takakurausp/diy_nanodrop/nanodrop_circuit.png

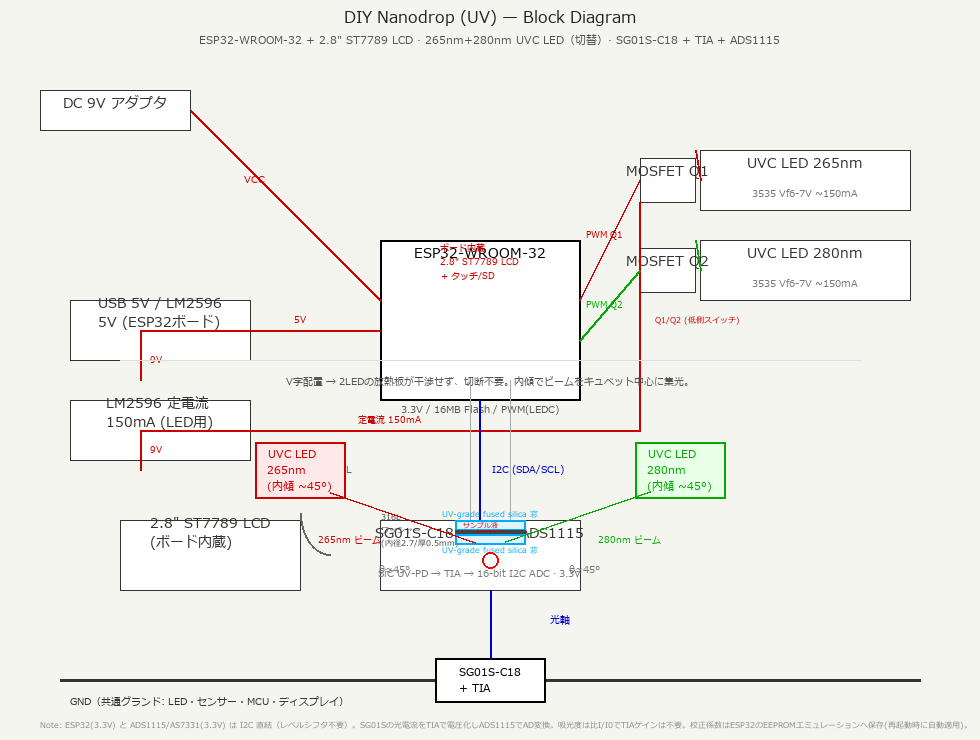
nanodrop_circuit.png
