takakurausp/diy_nanodrop/nanodrop_BOM.md

# DIY Nanodrop (UV) — 部品リスト（BOM）/ Cost-optimized, 260+280nm dual measurement
> SG01S-C18（SiC UVフォトダイオード）+ TIA + ADS1115 + ESP32 構成。AS7331 もビルドオプション選択可。旧 GUVA-S12SD 版は `main`、LGT8F328P+AS7331 版は `as7331` ブランチを参照。
>
> 前提ボード: **ideaspark ESP32 2.8" IPS LCD タッチボード (240x320, ST7789)** — https://www.amazon.co.jp/dp/B0HHSHFZ8Q

## コア部品
| # | 部品 | 仕様 / 品番 | 用途 | 参考価格 | 購入先 |
|---|---|---|---|---|---|
| 1 | 開発ボード | **ESP32-WROOM-32 + 2.8" IPS LCD (ST7789 240x320) + XPT2046タッチ + microSD 一体ボード** (16MB Flash, 3.3V, USB Type-C) | メインMCU兼ディスプレイ。空きGPIO 5/12/16/17/21/22/25/26/33 | ¥1,299 | [Amazon](https://www.amazon.co.jp/dp/B0HHSHFZ8Q) |
| 2 | UVC LED | 265nm SMD 3535 単一素子 (Vf 6-7V, ~150mA) | DNA A260光源 | ¥100〜300/個 | [AliExpress](https://www.aliexpress.com/item/1005009337588215.html) |
| 3 | UVC LED | 280nm SMD 3535 単一素子 (Vf 6-7V, ~150mA) | タンパク質 A280光源 / 純度比用 | ¥100〜300/個 | [AliExpress](https://www.aliexpress.com/item/1005009337588215.html) |
| 4 | UVセンサー(既定) | **SG01S-C18** (sglux SiC UVフォトダイオード, TO-18, 単一ch) + **トランスインピーダンスアンプ(TIA)** + **ADS1115** (16-bit I2C ADC) | 自作センサーモジュール。光電流 → TIA → ADS1115 でAD変換。吸光度は比 I/I0 なので TIA ゲインは式上キャンセル | SG01S ¥3,000〜5,000 / ADS1115 ¥300〜600 | sglux 等 / AliExpress |
| 4b | UVセンサー(代替) | **AS7331** モジュール (SparkFun SEN-23517 Qwiic 1x1 / 23518 Mini, 2.7-3.6V) | 3ch(UVA/UVB/UVC)デジタルI2C検出器。ビルド時 `SENSOR_AS7331=1` で選択 | ¥2,500〜3,500 | SparkFun/スイッチサイエンス 等 |
| 4c | UVセンサー(旧/互換) | **GUVA-S12SD** モジュール (アナログ出力 0-1V) | 同じアナログ経路が使えるが単一広帯域chで感度・選択性は SG01S より劣る | ¥200〜500 | AliExpress/Amazon |
| 5 | MOSFET | **MTA100N10KRI3** (N-ch, TO-251, Vds100V, Id10A, RDS(on)@4.5V=112mΩ, 論理レベル) | LED駆動用スイッチ ×2（低側） | ¥100×2 | Amazon/通販 |

## 抵抗・保護
| # | 部品 | 値 | 用途 |
|---|---|----|---|
| 6 | ゲート抵抗 | 100Ω | MOSFETゲート直列(振動抑制) ×2 |
| 7 | フライバックダイオード | 1N4148 または SS34 | LED逆起電流保護 ×2 (任意だが推奨) |
| 8 | デカップリングコンデンサ | 100µF + 0.1µF | 電源ノイズ除去(MCU/センサー共通) |
| 8a | TIA用オペアンプ | 低入力バイアス電流・低オフセット（例: LMP7721, OPA381, OPA333） | SG01S の光電流を電圧へ I-V 変換 |
| 8b | TIA帰還抵抗 Rf | 1MΩ〜10MΩ（薄膜・低ドリフト） | 変換ゲイン G=Iph×Rf。出力が ADS1115 の ±4.096V 内に収まる値にする |
| 8c | TIA帰還コンデンサ Cf | 1〜10pF（C0G/NP0） | 発振防止・帯域制限 |

## 電源(9V供給・LED用定電流 + 5V生成)
| # | 部品 | 仕様 / 品番 | 用途 |
|---|---|---|---|
| 14 | 定電流ドライバ(LD用) | LM2596 CC/CV降壓モジュール(二つトリム:電流+電圧) | LED用定電流。電流トリムを150mAに固定し、順電圧に合わせて自動調整 |
| 15 | 降圧DC-DC(MCU用) | LM2596 降壓モジュール(5V固定) | ESP32ボードへ 5V 給電（ボード上のレギュレータで3.3V生成）。3端子レギュタより発熱が小さい |
| 16 | 9V電源 | DC9Vアダプタ(500mA〜1A級) | 装置全体への供給。USB給電でも可 |

### 電源構成（9V供給）
- **LM2596×2**: 1つはLED用定電流(150mA固定)、もう1つはESP32ボード用5V定電圧（USB Type-C給電なら不要）。
- ESP32ボードは 5V 入力（USB/5Vピン）を受け、オンボードで 3.3V を生成。AS7331 も同じ 3.3V から給電。
- LED素子は順電圧6〜7V。9V供給により定電流驱动に十分な電圧差があり、抵抗直列不要。

## AS7331 UVセンサ（I2Cデジタル・オプション）
- **AS7331 は I2C 接続のデジタルUVセンサ**。アナログの GUVA-S12SD と異なり ADC 不要で、UVA/UVB/UVC の3チャンネルを同時にカウント値で出力する。`Wire` のみで動作し、外部ライブラリは不要（ドライバは `nanodrop.ino` 内に実装）。
- **I2Cアドレス**: 0x74（A1=A0=0、SparkFunボードのデフォルト）。ESP32 の空きGPIO **SDA=GPIO21 / SCL=GPIO22** を使用。
- **チャンネル割当**: 265nm LED → **UVC** (200-280nm) / 280nm LED → **UVB** (280-320nm)。
- **設定（デフォルト）**: ゲイン 2x、変換時間 64ms、変換クロック 1.024MHz、CMD（ワンショット）モード。測定は「LED点灯 → 安定待ち300ms → 変換開始 → 64ms待ち → 読み出し」の順。
- **換算**: 生カウント → µW/cm²（データシート式3, `as7331CountsToUwCm2()`）。吸光度はブランク比 I/I0 なので絶対校正は不要だが、ゲイン/変換時間を変えた場合は要再確認。
- **利点**: 分光感度が既知・チャンネル分離により、GUVA-S12SD のような広帯域クロストークが減る。暗電流/ノイズもデジタルで安定。
- **電圧**: AS7331 は **2.7〜3.6V (3.3V)** 動作。**ESP32 も 3.3V なのでレベルシフタ不要で直結可能**（AS7331 を 3.3V 給電、I2C プルアップはモジュール側）。旧 LGT8F328P(5V) 構成ではレベルシフタが必要だった。

## SG01S-C18 + TIA + ADS1115 検出器（既定）
- **既定の検出器**。sglux **SG01S-C18**（SiC UVフォトダイオード、単一チャンネル）の光電流を **トランスインピーダンスアンプ(TIA)** で電圧に変換し、**ADS1115 (16-bit I2C ADC)** でAD変換する自作モジュール。`SENSOR_AS7331=0`（既定）でビルドされる。
- **単一の広帯域チャンネル**: 265nm/280nm どちらのLEDでも同じ検出器を読む。吸光度は比 I/I0 なので成立するが、チャンネル分離が無いためクロストークは AS7331 より悪い。
- **校正不要な設計**: 吸光度は比 I/I0 で求めるため、Rf や絶対感度は式上キャンセルされる（TIA ゲインは結果に効かない）。ただし出力が ADS1115 のフルスケール内に収まるよう Rf を選ぶこと（本ファームは **PGA=±4.096V**, `ADS1115_CFG_START=0xC383`）。TIA 出力は**正**に振れること（負電圧は ADS1115 の単電源入力範囲外）。
- **外付けADC推奨**: ESP32 内蔵ADCはノイズ・非直線性が大きく、また TIA 出力を 0-3.3V に収める必要がある。ADS1115 は ±4.096V 設定でフルスケールを広く取れて安定。LSB=125µV。
- 配線: `SG01S-C18 -> TIA -> ADS1115 AIN0`, `ADS1115 SDA/SCL -> GPIO21/22`, `ADDR -> GND (0x48)`, `VDD -> 3.3V`。
- 内蔵ADCを使う場合は `PD_USE_ADS1115=0` とし、TIA 出力を **GPIO33 (ADC1_CH5)** へ（TIA は 3.3V 給電で出力がレンジ内に収まること）。
- ブランク信号の下限 `MIN_SIGNAL`（ADS1115 時は 50 カウント ≈ 6mV）は TIA 出力レベルに合わせて調整する。
- GUVA-S12SD 等の他のアナログUV素子でも同じ経路が使える。

## ESP32ボード内蔵ピン（変更不可）
| 機能 | ピン |
|---|---|
| LCD (ST7789) | CS=15, DC=2, RST=4, BL=32 |
| 共有VSPI | SCK=18, MISO=19, MOSI=23 |
| タッチ (XPT2046, 未使用) | CS=14, IRQ=27 |
| microSD (未使用) | CS=13 |
| ユーザー空きGPIO | 5, 12, 16, 17, 21, 22, 25, 26, 33 |

### 本スケッチの割当
| 用途 | GPIO |
|---|---|
| LED_265 PWM | 16 |
| LED_280 PWM | 17 |
| ADS1115 / AS7331 SDA / SCL | 21 / 22 |
| 校正ボタン（INPUT_PULLUP, 押下=GND） | 25 |
| アームスイッチ（INPUT_PULLUP, 押下=GND） | 26 |

## EEPROM（校正係数の保存）
- **ESP32 の EEPROM エミュレーション**を使用（`EEPROM.begin(64)` で確保、`EEPROM.commit()` でフラッシュへ書き込み）。
- 校正モードで算出した**K/B係数を保存**（packed構造体＋checksumで保護）。再起動時に自動読み込みされ、通常測定に適用される（PC不要）。
- 有効性判定用マジック番号・チェックサム付き。破損・未保存時はデフォルト(1.0/0.0)に戻る。
- コード: `saveCalibration()` / `loadCalibration()`（nanodrop.ino）。

## 標準溶液の作り方（校正用）
校正には**既知真値の標準溶液2種**が必要。各波長の生吸光度(A_meas)と真値から2点法でK/Bを算出する。

### DNA標準液 (A260 = 1.0 ≡ 50µg/mL dsDNA, 1cm光路長)
- **試薬**: 高純度dsDNA（ラット肝臓DNA等、NIST/SRM級が望ましい）
- **調製**: DNAをTE緩衝液(pH8.0)に溶かし、**50µg/mL** に希釈。
- **既知真値(260nm)**: A260 = 1.0（1cm光路長・50µg/mL）。
- **既知真値(280nm)**: 純粋なDNAなら約0.47（A260/A280≈2.1の逆数付近、実測で確認推奨）。

### リゾチーム標準液 (タンパク質基準)
- **試薬**: リゾチーム（lysozyme、食品級/分析用）
- **既知真値**: 質量吸光係数 A(1%,1cm)₂₈₀ = 2.6。
- **調製例**: リゾチームを純水に溶かし、**1% (10mg/mL)** にする。
- **既知真値(280nm)**: A280 = 2.6 × (光路長cm) → 0.5mm(0.05cm)なら A280 ≈ 0.13。
- **既知真値(260nm)**: リゾチームのA260/A280 ≈ 0.57 → A260 ≈ 0.57 × A280。

### 注意点
- 両標準は**各波長で十分な差があること**（コードはdenom<1e-4ならエラー）。DNAは260nmで大きく、リゾチームは280nmで大きく反応する。
- 溶液は直前に調製し、気泡・沈殿を避ける。サンプルセル(0.5mm)に滴下してアームで挟む。
- 真値は**実測の波ズレ・検出器感度で補正される**ため、厳密値より相対比が重要。

## 光学・構造(3Dプリンタ推奨)
| # | 部品 | 仕様 / 品番 | 用途 |
|---|---|---|---|
| 9 | サンプルセル（光路長定義） | **316Lステンレス ワッシャー 内径2.7mm・厚さ0.5mm** + UV-grade fused silica 窓(直径8〜9mm) | 光路長0.5mmを定義し、サンプル液を表面張力で保持。金属が外光ノイズを遮断 |
| 10 | アルミ導光パイプ | 内径3mm程度・鏡面仕上げ（またはアノダイズ処理品） | LED発光部からサンプルセルまでUVCを反射で導く。短く・鏡面に近い状態に |
| 11 | ピンホール/スリット | — | LED光を点光源化しセンサーへ誘導 |
| 12 | 遮光ケース | — | 外光ノイズ防止。UV漏れ注意(黒色ケース) |

### サンプルセルの設計（内径2.7mm / 厚さ0.5mm）
- **316Lワッシャー肉厚 = 光路長 0.5mm**。標準溶液(50µg/mL)でA260≈0.025となり、微量(~1µL)で測定可能。
- UV-grade fused silica（QS/Suprasil等）が必須。ソーダ・リム系石英は260nmで吸収NG。窓×2の反射ロス(約4〜5%/面)はBLANK再測定で相殺。
- 光路長1mm案との比較: 希薄サンプル(<50µg/mL)も正確に測るなら1mm、通常(~100µg/mL以上)が主なら0.5mmが本意。純度比(A260/A280)は光路長に依存しない。
- アルミ導光パイプ: 反射率は裸アルミで260nm約75〜85%。複数反射で減衰するので短く・鏡面を維持。集光ではなく通過なので、LEDと開口の距離が離れすぎないよう注意。

## オプション
| # | 部品 | 用途 |
|---|---|---|
| 12 | USB Type-C ケーブル / 5V電源 | 書き込み・給電（ボード付属のUSB端子） |
| 13 | LiPoバッテリ + 充電基板 | 携帯運用（任意） |

## 合計コスト目安
- **ESP32 LCDボード込み: ¥5,000〜7,500 前後**（LCD・タッチ・SD一体で¥1,299、SG01S-C18 約¥3,000〜5,000 + ADS1115 約¥300〜600 + TIA部品）
- 遮光ケース・標準試薬等を加えても ¥6,000〜8,000

## 設計上の注意点
- **既定は SG01S-C18 + TIA + ADS1115**。光電流を I-V 変換してADCへ。吸光度は比 I/I0 なので TIA ゲインは結果に効かず、出力がフルスケール内に入っていればよい。
- AS7331（オプション）は I2C デジタル出力。分光応答はチャンネル毎に定義済みで、265nm は UVC、280nm は UVB で受光する。ゲイン/変換時間を変えると換算係数も変わる点に注意。
- **電圧**: ESP32・SG01S/TIA・ADS1115・AS7331 とも 3.3V で統一。ADS1115/AS7331 はレベルシフタ不要で I2C 直結できる（旧5V MCU構成から簡素化）。
- LED駆動は ESP32 の `analogWrite`（LEDC PWM, 0-255）を使用。
- 吸光度は「ブランク(純溶媒)に対する透過光の減衰」で算出 → 各波長で必ずブランク測定を行う。
- 全部品を**共通グランド**に結ぶ（ESP32 と LEDドライバ・センサーの GND 共通）。
