takakurausp/diy_nanodrop/(commit log)

2026-09-21 Add AS7331 UV sensor fork (I2C digital, UVC/UVB channels)
    Replace analog GUVA-S12SD (A0) with the AS7331 spectral UV sensor
    (SparkFun SEN-23517). 265nm LED -> UVC channel, 280nm LED -> UVB
    channel; raw counts converted to uW/cm2 then A=-log10(I/I0).
    - In-sketch AS7331 driver over Wire (CMD/one-shot), no external lib
    - Calibration, EEPROM storage, OLED UI and state machine unchanged
    - Note 2.7-3.6V operation and I2C level shifting for the 5V MCU
    - Update BOM, README and regenerated block diagram
    [main.cpp, make_diagram.py, nanodrop.ino]
2026-09-22 Port to ESP32 + 2.8in ST7789 touch LCD with touch UI
    Hardware: ideaspark ESP32 2.8" IPS LCD touch board (ESP32-WROOM-32,
    ST7789 240x320, XPT2046 touch). AS7331 now connects directly at 3.3V.
    - Touch UI: home with Calibration / Measuring / Settings large buttons
    - Calibration: checks EEPROM, guided 3-step (blank, DNA 50ug/mL,
    protein 1% w/v), saves K/B to EEPROM
    - Measuring: blank then sample each time; shows A260/A280/purity/conc;
    records kept in memory; warns to apply blank before next sample
    - Settings: backlight brightness, WiFi scan + WPS, Wi-Fi erase,
    2-point touch calibration
    - WiFi: stored credentials -> STA, else AP mynanodrop/12345678 at
    192.168.5.1; WebServer serves / and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
2026-09-22 Add GUVA-S12SD analog fallback with ADS1115 support
    The AS7331 can be hard to source, so allow using the analog GUVA-S12SD
    module instead, selected at compile time.
    - Add SENSOR_AS7331 (default 0) and GUVA_USE_ADS1115 (default 1) switches
    - Wrap AS7331 driver in #if SENSOR_AS7331
    - Add in-sketch ADS1115 driver (16-bit I2C, PGA +/-2.048V, single-shot)
    and an ESP32 internal ADC path (AOUT -> GPIO33)
    - Add sensorBegin() / refactor measureUV(); rename threshold to MIN_SIGNAL
    - Docs: README sensor options and ADC rationale, BOM alternative row/section
    - platformio.ini: document build_flags for each sensor mode
2026-09-23 Switch default sensor to SG01S-C18 + TIA + ADS1115, add LED tune mode
